carlyjb/SumoPcb/pix/Sumo 1 top.png

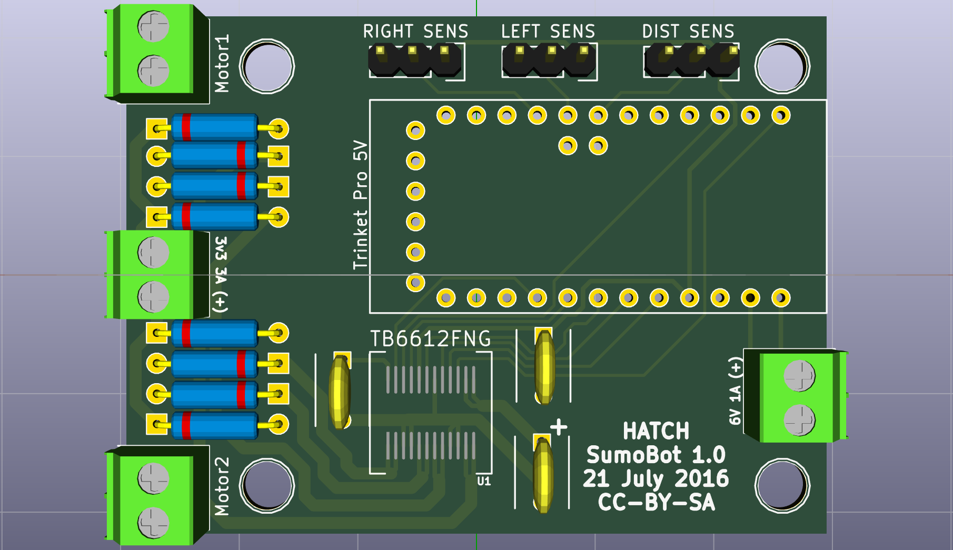
pix/Sumo 1 top.png
