carlyjb/SumoPcb/pix/Sumo v0 bottom.png

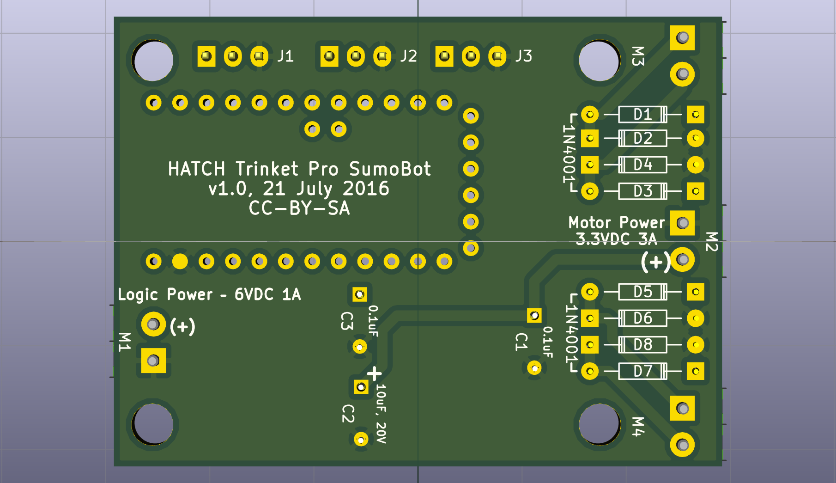
pix/Sumo v0 bottom.png
