carlyjb/SumoPcb/HatchBot.kicad_pcb

## KiCad design HatchBot.kicad_pcb (2017-03-03)

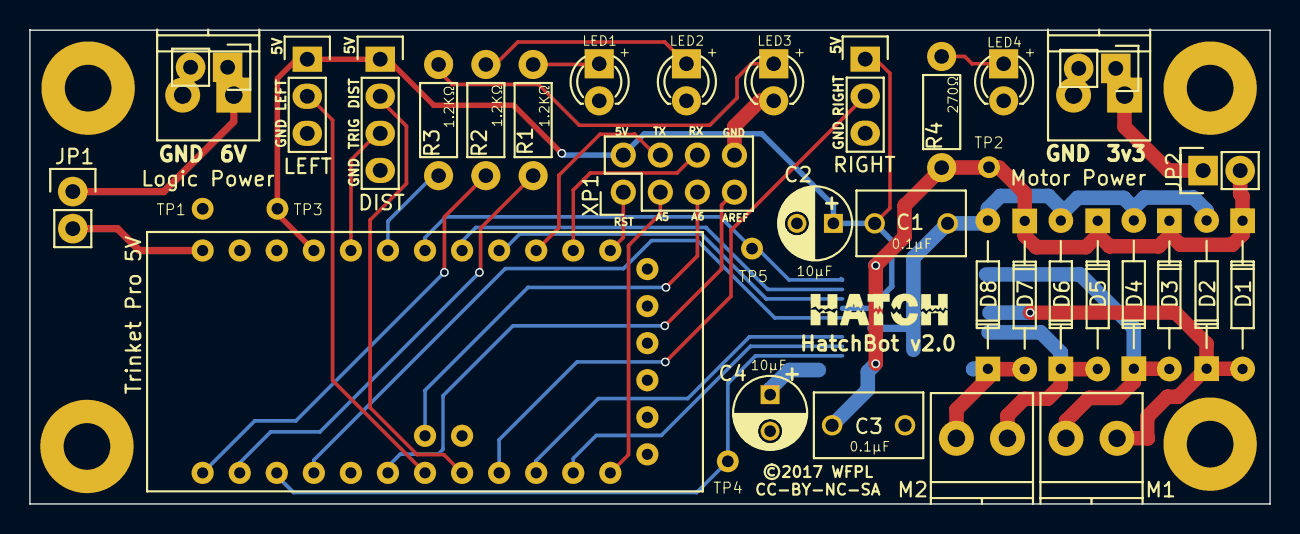
[picture p3: board HatchBot.kicad_pcb from above]

Board: 2 copper layers, 85.0 x 32.5 mm, 37 parts (1 on the bottom side), 34 nets.

Parts:
C1, C3: 0.1µF; C_Disc_D7.5_P5
C2, C4: 10µF; C_Radial_D5_L6_P2.5
D1, D2, D3, D4, D5, D6, D7, D8: 1N4001; Diode_DO-35_SOD27_Horizontal_RM10
J1: Trinket Pro 5V; Trinket_Pro_5V
JP1: JP1; Pin_Header_Straight_1x02
JP2: JP2; Pin_Header_Straight_1x02
LED1, LED2, LED3, LED4: LED; LED-3MM
LPWR1: Logic Power; TerminalBlock_Pheonix_PT-3.5mm_2pol
M1: Motor1; TerminalBlock_Pheonix_PT-3.5mm_2pol
M2: Motor2; TerminalBlock_Pheonix_PT-3.5mm_2pol
Motor Power: Motor Power; TerminalBlock_Pheonix_PT-3.5mm_2pol
P1: DIST; Pin_Header_Straight_1x04
P2: LEFT; Pin_Header_Straight_1x03
P3: RIGHT; Pin_Header_Straight_1x03
R1, R2, R3: 1.2KΩ; Resistor_Horizontal_RM7mm
R4: 270Ω; Resistor_Horizontal_RM7mm
TP1: GND TEST; Measurement_Point_Round-TH_Small
TP2: V_MOTOR TEST; Measurement_Point_Round-TH_Small
TP3: V_LOGIC TEST; Measurement_Point_Round-TH_Small
TP4: PWMB TEST; Measurement_Point_Round-TH_Small
TP5: PWMA TEST; Measurement_Point_Round-TH_Small
U1: TB6612FNG; SSOP-24_5.3x8.2mm_Pitch0.65mm
XP1: EXP; Pin_Header_Straight_2x04

Connections:
A01: D3.2, D4.1, M1.1, U1.1, U1.2
A02: D1.2, D2.1, M1.2, U1.5, U1.6
A5: J1.25, XP1.3
A6: J1.26, XP1.5
AIN1: J1.3, U1.21
AIN2: J1.4, U1.22
AREF: J1.19, XP1.7
B01: D7.2, D8.1, M2.1, U1.11, U1.12
B02: D5.2, D6.1, M2.2, U1.7, U1.8
BIN1: J1.23, U1.17
BIN2: J1.24, U1.16
GND_LOGIC: C1.2, C2.2, C3.2, C4.2, D2.2, D4.2, D6.2, D8.2, J1.16, LED1.1, LED2.1, LED3.1, LED4.1, LPWR1.2, Motor Power.2, P1.4, P2.3, P3.3, TP1.1, U1.3, U1.4, U1.9, U1.10, U1.18, XP1.8
LED1: J1.10, R1.1
LED2: J1.9, R2.1
LED3: J1.6, R3.1
unnamed: LED1.2, R1.2
unnamed: LED2.2, R2.2
unnamed: LED3.2, R3.2
unnamed: LED4.2, R4.2
PWMA: J1.5, TP5.1, U1.23
PWMB: J1.11, TP4.1, U1.15
RST: J1.1, XP1.1
RX: J1.34, XP1.6
SENS_DIST: J1.21, P1.2
SENS_LEFT: J1.20, P2.2
SENS_RIGHT: J1.22, P3.2
STBY: J1.12, U1.19
TRIG_DIST: J1.8, P1.3
TX: J1.35, XP1.4
V_BAT: J1.17, JP1.2
V_BAT_IN: JP1.1, LPWR1.1
V_LOGIC: C1.1, C2.1, J1.14, P1.1, P2.1, P3.1, TP3.1, U1.20, XP1.2
V_MOTOR: C3.1, C4.1, D1.1, D3.1, D5.1, D7.1, JP2.2, R4.1, TP2.1, U1.13, U1.14, U1.24
V_MOTOR_IN: JP2.1, Motor Power.1
