carlyjb/SumoPcb/(commit log)

2016-07-21 Added files
    Added files for sumo bot pcb board. Does not break out extra pins.
    [Adafruit Pro Trinket 3v3.brd, Adafruit Pro Trinket 3v3.sch, Adafruit Pro Trinket 5v0.brd, Adafruit Pro Trinket 5v0.sch, Sumo 1.kicad_pcb, Sumo 1.sch, sumo.kicad_pcb, sumo.sch]
2016-07-22 First spin using bare SMT TB6612FNG.
    [Sumo 1.kicad_pcb, Sumo 1.sch]
2016-07-22 New spin!
    [Sumo 1.kicad_pcb, Sumo 1.sch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]
2016-08-31 Sumo v1 files
    [Sumo 1.kicad_pcb, Sumo 1.sch, sumo v0.kicad_pcb]
2016-12-31 Drop old V0 files — that’s the version before we split the motor and logic power into separate areas.
    [sumo v0.kicad_pcb]
2016-12-31 Drop Gerber files and Adafruit Pro Trinket board files
    [Adafruit Pro Trinket 3v3.brd, Adafruit Pro Trinket 3v3.sch, Adafruit Pro Trinket 5v0.brd, Adafruit Pro Trinket 5v0.sch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]
2017-01-12 Rename “Sumo 1” -> HatchBot.
    [HatchBot.kicad_pcb, HatchBot.sch]
2017-01-12 Rename ArduinoFootprints -> HatchFootprints
2017-01-12 Scrap kicad_tutorial directory
    [sumo.kicad_pcb, sumo.sch]
2017-02-27 Spin 2, first cut.
    [HatchBot.kicad_pcb, HatchBot.sch]
2017-02-28 Move the motor-power section a bit to the right. Flip the LEDs. Fix up some labels.
    [HatchBot.kicad_pcb]
2017-03-02 Final tweaks (more sane test point placement, switch back to filled zones for doubled pads, add the Hatch logo).
    [HatchBot.kicad_pcb, HatchBot.sch]
2017-03-02 Gerber files.
    [HatchBot-B.Cu.gbl, HatchBot-B.Mask.gbs, HatchBot-B.SilkS.gbo, HatchBot-Edge.Cuts.gm1, HatchBot-F.Cu.gtl, HatchBot-F.Mask.gts, HatchBot-F.SilkS.gto, HatchBot.drl]
2017-03-02 Note on LEDs.
