carlyjb/SumoPcb/(notices)

Notices in the files:
HatchBot.kicad_pcb:
©2017 WFPL
CC-BY-NC-SA
